JehonaD/CyberPlants-Automated-Hydroponics-Solution-Maintenance-and-Monitoring-/LCD.jpg

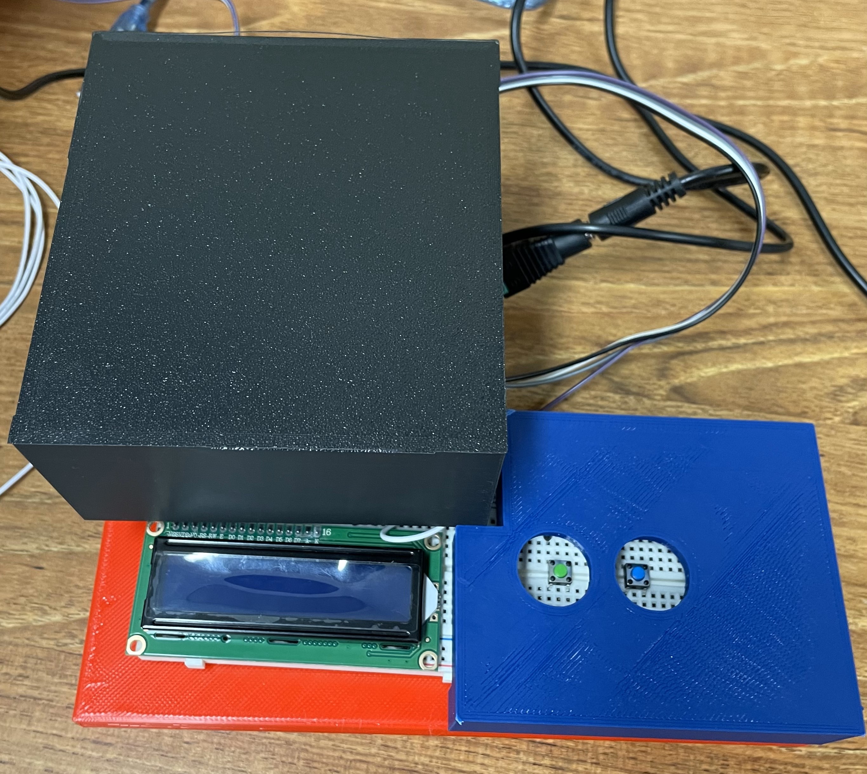
LCD.jpg
