JehonaD/CyberPlants-Automated-Hydroponics-Solution-Maintenance-and-Monitoring-/(commit log)

2024-12-04 Create Initial Calibration Code
2024-12-04 Added Schematic_images.png
2024-12-04 Add Schematic_pictures
